VynicyusCandido/iotHorangoTango/(commit log)

2026-09-15 Revise README for parking space monitoring project
    Updated project description and functionality details for parking space monitoring system using ultrasonic sensors and ESP32.
2026-09-15 Adicionado código de nó de sensor
    Código responsável por controlar nó da arquitetura responsável por monitorar os sensores das vagas
2026-09-16 Add MQTT and Wi-Fi functionality for LED control
2026-09-22 Revise README for clarity on system architecture
    Updated the README to clarify the roles of the sensor and actuator nodes, and improved the descriptions of MQTT publication and subscription processes.
2026-10-02 Publish spot state on boot and after MQTT reconnect
    The sensor only published on state changes and started with
    ocupada=false, so a spot that was free at boot was never published and
    a stale retained "ocupada" stayed on the broker. Changes made while
    disconnected were also lost.
    Track a per-spot pending flag, set on boot and on every reconnect, and
    keep it set when publish fails so the next reading retries.
    [no_sensor.ino]
2026-10-02 Support multiple sensor nodes and show offline spots
    Spot numbers were derived from the array position (i + 1), so two
    sensor nodes would both publish garagem/vaga/1, and reordering the
    array in one sketch silently mapped LEDs to the wrong spot. Client IDs
    were hardcoded, so flashing the same sketch on two boards made them
    kick each other off the broker.
    - Add an explicit `numero` field to each spot in both sketches; the
    actuator looks spots up by number and ignores ones it doesn't own.
    - Generate client IDs from the ESP32 MAC.
    - Sensor sets a Last Will of "offline" (retained) on
    garagem/no/<id>/status, publishes "online" on connect, and publishes
    the list of spots it monitors on gara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
    [no_sensor.ino]
2026-10-02 Turn off actuator LEDs when the sensor node goes offline
    When a sensor node dropped, the actuator kept showing the last known
    state, which could be wrong. Subscribe to garagem/no/# as well and
    track each node's online status and the spots it monitors. A spot whose
    monitoring nodes are all offline now has both LEDs off, matching the
    app's "Sem dados" state; they come back when the node reconnects.
    LEDs also start off at boot until the spot's state arrives, instead of
    assuming the spot is free. The message buffer grows to 128 bytes to fit
    a node's spot list.
2026-10-02 Move sketches into Arduino sketch folders
    The actuator sketch had no .ino extension (and a typo in its name), so
    the Arduino IDE could not open it, and neither sketch lived in a folder
    matching its name as the IDE requires. Move them to
    src/sensor/sensor.ino and src/atuador/atuador.ino, which is also the
    layout the README already described.
    Update the README's repository structure to list the actual files and
    say which sketch to load on each ESP32.
2026-10-02 Move Wi-Fi credentials out of the sketches
    The actuator sketch had the Wi-Fi SSID and password hardcoded and
    committed to a public repository. Both sketches now read WIFI_SSID and
    WIFI_PASSWORD from a per-sketch secrets.h, which is gitignored, and
    stop with a clear #error if it is missing. A secrets.example.h template
    is committed next to each sketch.
    Document the setup (including the extra secrets.h tab needed on Wokwi)
    in the README.
    The old password remains in git history, so it should be rotated if it
    belongs to a real network.
    [atuador.ino, secrets.example.h, sensor.ino]
2026-10-27 Merge sensor and actuator sketches into garagem firmware
    Consolidate src/sensor and src/atuador into a single src/garagem sketch
    with robust HC-SR04 reading: a failed read publishes "erro" on the
    vaga topic, and the app now shows "falha no sensor" for it instead of
    treating the spot as free/occupied.
    Also add project docs: CP12 deliverable, ADR 0001 (RFID + driver app),
    firmware flowchart and pin map, and rewrite the README accordingly.
2026-10-28 Add ADR 0002 on the switch from parcel scale to smart garage
    The initial N1 proposal (docs/IOT_24_08.pdf, 26/08) was a parcel scale
    with load cells; on 14/09 the team switched to the smart garage because
    of the hardware available and how it can grow to N3 within those
    limits. Record the decision retroactively and cite it in CP12 section 1
    so the old proposal in the repo does not read as an unjustified
    project change.
2026-11-10 Add planned N3 prototype illustration to README
2026-11-10 Migrate firmware to MQTT contract v1 with offline event queue
    - Switch PubSubClient for arduino-mqtt to publish with QoS 1
    - JSON payloads on garagem/v1/{deviceId}/... (estado, rfid,
    telemetria, status with LWT), UID in uppercase hex
    - Single ordered queue (64) for state changes and tag reads, drained
    in order on reconnect; each event keeps the time it happened (NTP,
    uptime fallback)
    - Non-blocking Wi-Fi/MQTT reconnect; LEDs follow the sensor locally,
    red blinking on sensor failure
    - RC522 antenna gain at max for under-floor reading
    - Broker settings optional in secrets.h; types moved to tipos.h
    - ADR 0003, contract note, README and firmware flowchart updated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
2026-11-10 Run Mosquitto 2.1.2 in Docker Compose with auth and ACL
    - compose.yaml with eclipse-mosquitto:2.1.2-alpine, ports 1883/9001,
    persistent volume and healthcheck
    - broker/iniciar.sh builds the password file from .env on startup
    (users: dispositivo, backend, monitor); .env.example versioned,
    .env ignored
    - allow_anonymous false; password-file and acl-file plugins
    - ACL: each ESP32 writes only under garagem/v1/<client id>/ and reads
    its own cmd; backend reads garagem/v1/# and is the only cmd
    publisher; monitor is read-only
    - Persistence on, so retained state and status survive restarts
    - Move mosquitto.conf to broker/; README broker section rewritten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
2026-11-10 Add commands, reservation with blue LED and NVS config to firmware
    - Subscribe to garagem/v1/{id}/cmd (QoS 1, clean session); acks go
    through the event queue in order: aceito -> estado -> executado
    - Validate per contract v1: PAYLOAD_INVALIDO (commandId null when
    missing), COMANDO_DUPLICADO (last 16 ids), ACAO_DESCONHECIDA,
    PARAMETRO_INVALIDO, VAGA_INEXISTENTE
    - reservar: only on a free spot; reserved spot -> VAGA_OCUPADA, unknown
    or failed sensor -> VAGA_EM_ERRO; ends on car arrival, timeout
    (counted on the device, also offline), cancel or sensor failure;
    duracao_min optional (configured default)
    - cancelar_reserva; SEM_RESERVA when not reserved
    - configurar: thresholds and defa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
